ostojaatanasijevic/PSG10M/README.md

# PSG10M

PSG10M is a simple 10 MHz signal generator. 

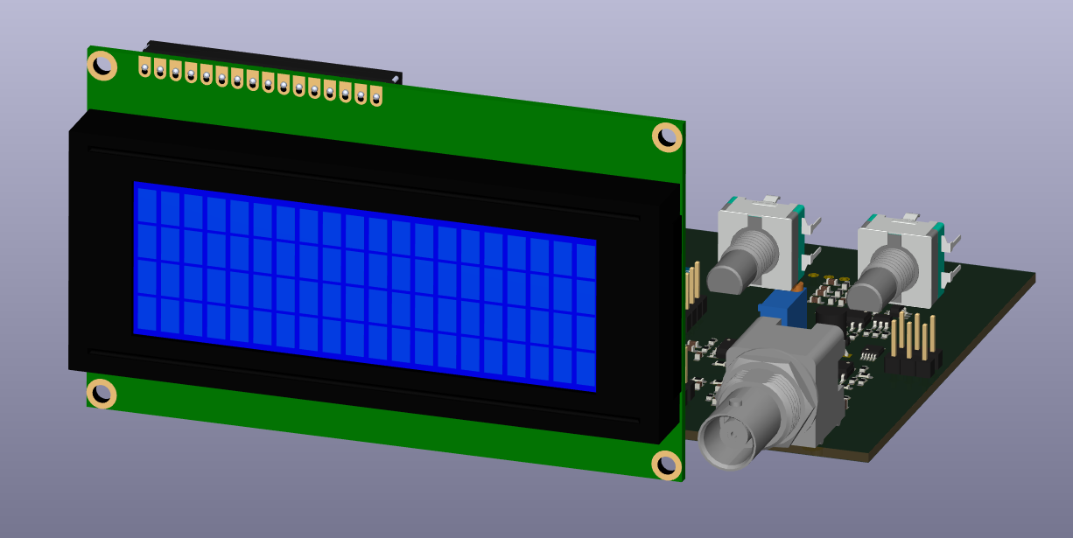
[picture p1: figs/PSG.png]
plot
