ostojaatanasijevic/PSG10M/LCD 16X2.STEP

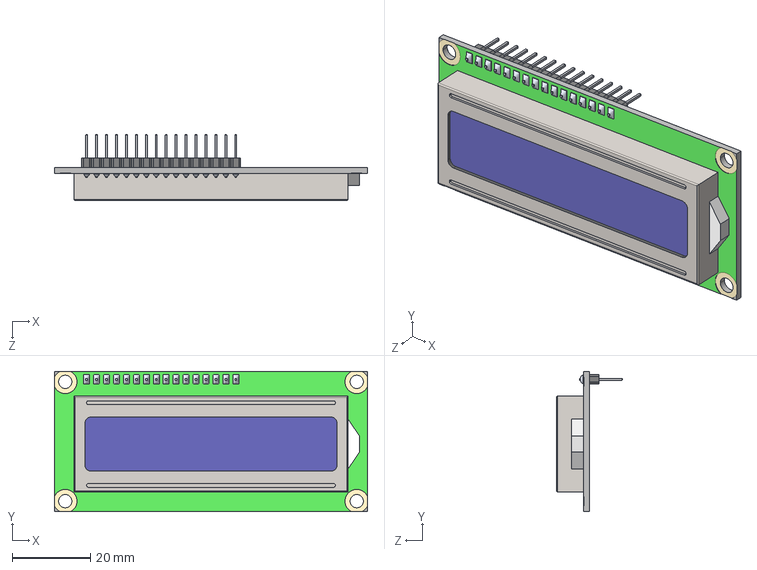
[picture p2: CAD file, 2024-11-09]
LCD 16X2.STEP
80.0 x 35.8 x 16.9 mm
