ostojaatanasijevic/PSG10M/1-5227161-6.stp

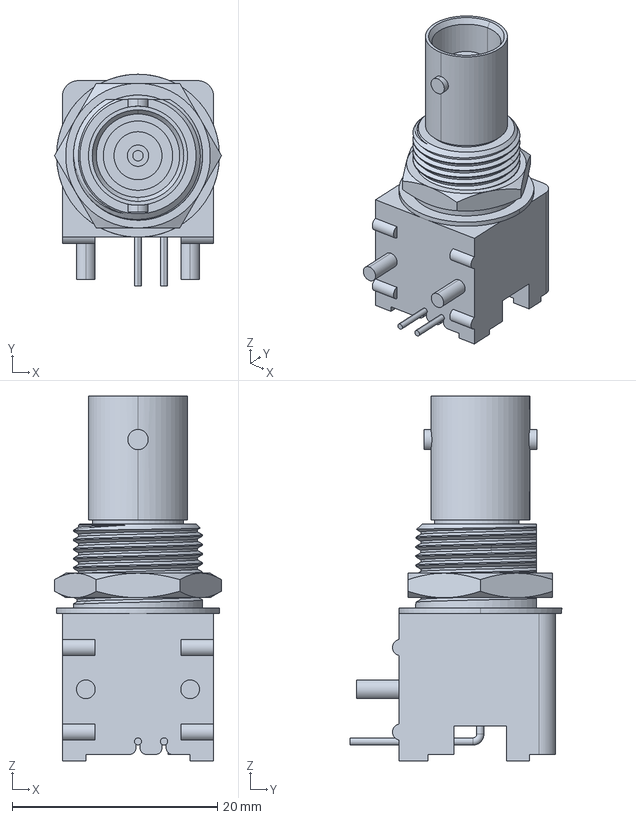
[picture p3: CAD file, 2024-11-02]
1-5227161-6.stp
16.3 x 20.6 x 35.6 mm
