ostojaatanasijevic/PSG10M/Ël__h.STEP

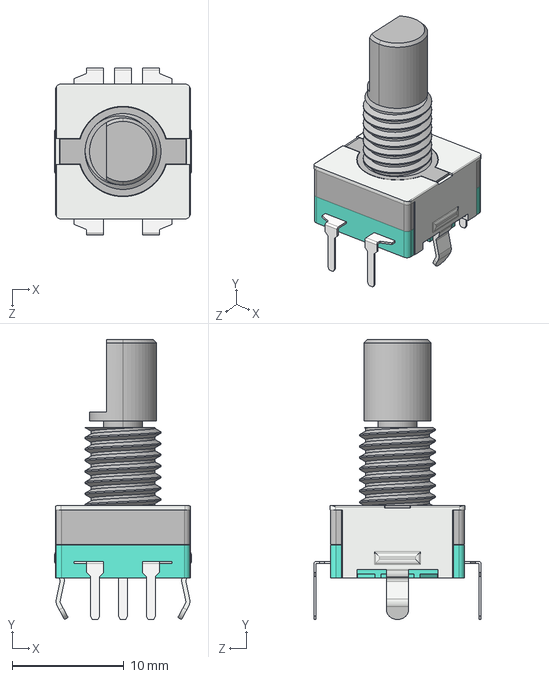
[picture p4: CAD file, 2024-11-02]
Ël__h.STEP
12.3 x 25.1 x 15.0 mm
