ostojaatanasijevic/PSG10M/LCD 20x4 Display.step

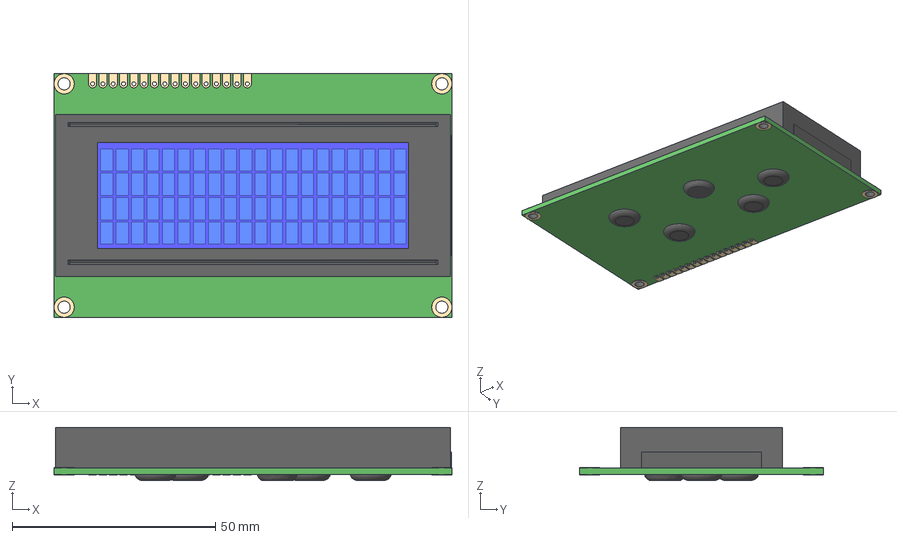
[picture p5: CAD file, 2024-11-02]
LCD 20x4 Display.step
98.0 x 60.0 x 13.1 mm
