ostojaatanasijevic/PSG10M/I2C LCD Adapter PCF8574.step

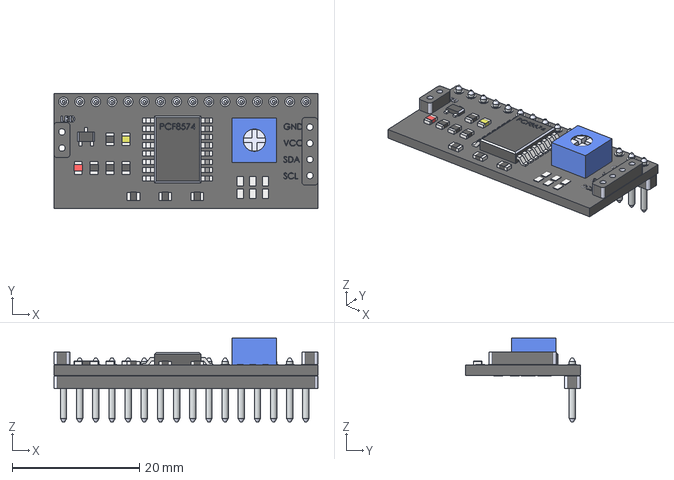
[picture p6: CAD file, 2024-11-02]
I2C LCD Adapter PCF8574.step
41.5 x 18.0 x 13.1 mm
