ostojaatanasijevic/PSG10M/simulacije/201_cd_offset.asc

C1: cap; 1µ
R1: res; 430
R2: res; 100
R3: res; 1k
R4: res; 430
R5: res; 430
R6: res; {(1 - x) * 1k}
R7: res; {(1 - x) * 1k}
R8: res; 100
R9: res; 200
R10: res; 200
R11: res; 100
R12: res; 200
R13: res; 100
R14: res; 100
R15: res; 1k
R16: res; 1k
R17: res; 100
U1: AD8009an
U2: LM339A_TI
U3: AD8009an
U4: AD8009an
U5: opamp2; LM7171
U6: AD8009an
U7: TL072
V1: voltage; PULSE(0 0.6 0 1n 1n 0.5u 1u)
V2: voltage; 5
V3: voltage; 5
V4: voltage; 15.3
V5: voltage; 15.3
V6: voltage; 0.1
Named nets: 5V, -5V, 0, -15V3, 15V3
.tran 1m
.param x = 0.5
.lib lm7171.lib
