ostojaatanasijevic/PSG10M/simulacije/101_amp.asc

R1: res; 430
R2: res; 100
R3: res; 1k
R4: res; 430
R5: res; 430
R6: res; {(1 - x) * 1k}
R7: res; {(1 - x) * 1k}
R8: res; 100
R9: res; 220
U1: AD8009an
U2: LM339A_TI
U3: AD8009an
U4: AD8009an
V1: voltage; SINE(0.325 0.3 1Meg)
V2: voltage; 5
V3: voltage; 5
Named nets: 5V, -5V, 0
.tran 1m
.param x = 0.5
