ostojaatanasijevic/PSG10M/simulacije/801_PWM_DAC.asc

C1: cap; 100n
C2: cap; 100n
R1: res; 100k
R2: res; 100k
V1: voltage; PULSE(0 1 0 10u 10u 1n 20u)
Named nets: 0
.tran 1000m
