ostojaatanasijevic/PSG10M/simulacije/901_output_filter.asc

C1: cap; 47p
C2: cap; 47p
C3: cap; 47p
C5: cap; 1p
C6: cap; 5.6p
C7: cap; 4.7p
L1: ind; 330n
L2: ind; 330n
L3: ind; 330n
R1: res; 200
V1: voltage; ""; AC 1
Named nets: 0
;tran 1000m
.ac dec 100 100k 100Meg
