ostojaatanasijevic/PSG10M/simulacije/701_capacitance_multiplier.asc

B1: bv; V=-V(vcc_in)
C1: cap; 47µ
I1: current; 30m
R1: res; 1k
R2: res; 10k
R3: res; 1k
R322: res; 3.3k
U2: bd679
V1: voltage; PULSE(-1 1 0 10u 10u 1n 20u)
V2: voltage; 20
V3: voltage; PULSE(-1 1 0 {t2} {t2} 1n {2*t2})
V4: voltage; 9
Named nets: 0, vee_in, vcc_in
.tran 1000m
.param t2 = 0.5u
.lib BD679.SP3
