ostojaatanasijevic/PSG10M/PSG10M.kicad_pcb

## KiCad design PSG10M.kicad_pcb (2025-01-06)

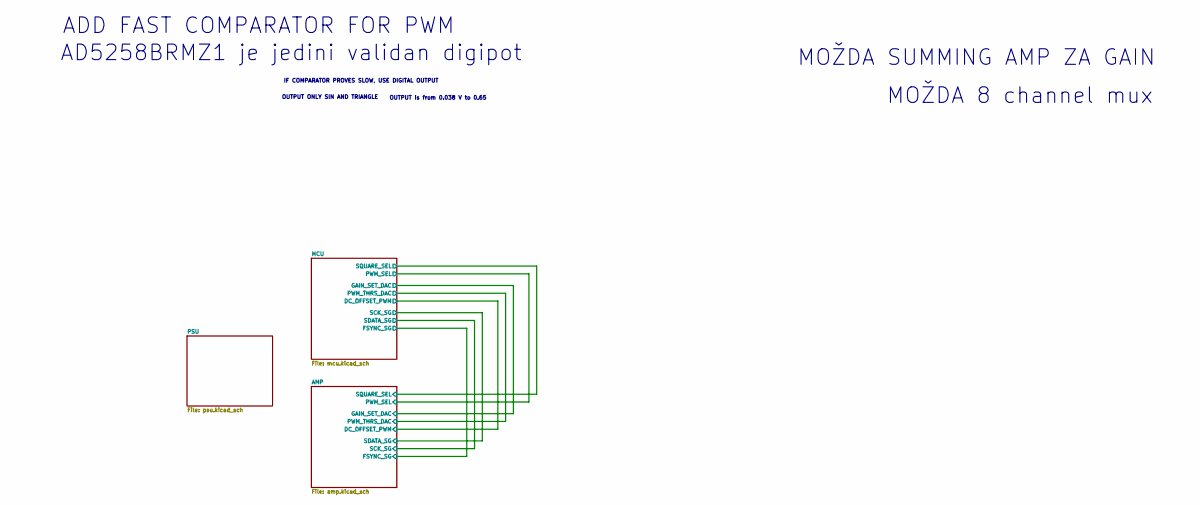
[picture p7: schematic PSG10M.kicad_sch]

Notes on the sheet:
OUTPUT is from 0.038 V to 0.65
IF COMPARATOR PROVES SLOW, USE DIGITAL OUTPUT
ADD FAST COMPARATOR FOR PWM
MOŽDA 8 channel mux
OUTPUT ONLY SIN AND TRIANGLE
AD5258BRMZ1 je jedini validan digipot
MOŽDA SUMMING AMP ZA GAIN

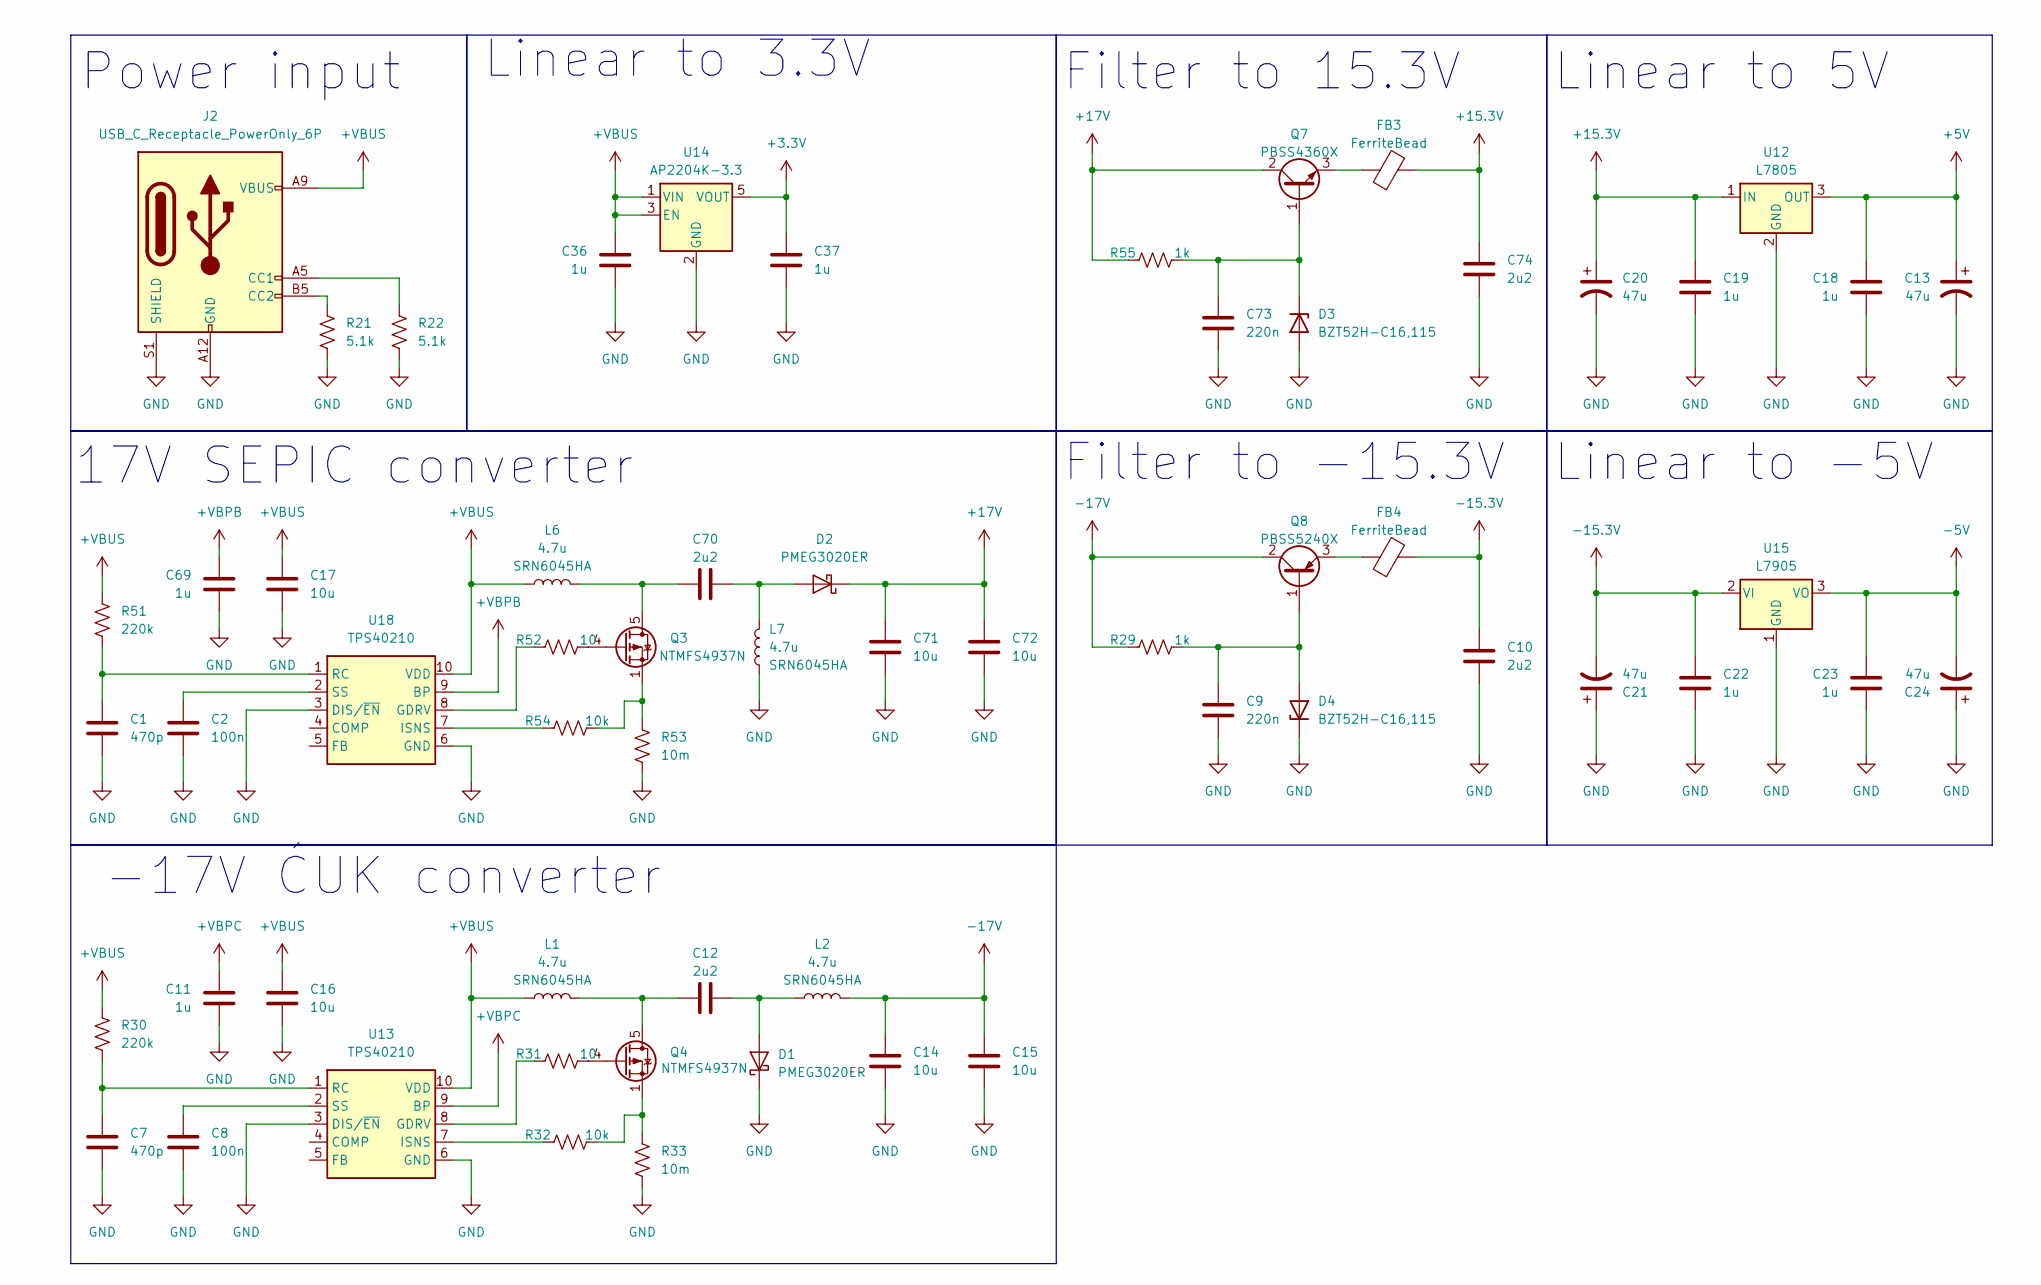
[picture p8: schematic psu.kicad_sch]

Parts:
C1, C7: 470p; R_0603_1608Metric_Pad0.98x0.95mm_HandSolder
C2, C8: 100n; R_0603_1608Metric_Pad0.98x0.95mm_HandSolder
C9, C73: 220n; R_0603_1608Metric_Pad0.98x0.95mm_HandSolder
C10, C12, C70, C74: 2u2; R_1206_3216Metric_Pad1.30x1.75mm_HandSolder
C11, C18, C19, C22, C23, C36, C37, C69: 1u; R_0603_1608Metric_Pad0.98x0.95mm_HandSolder
C13, C20, C21, C24: 47u; CP_Radial_D5.0mm_P2.00mm
C14, C15, C16, C17, C71, C72: 10u; R_1206_3216Metric
D1, D2: PMEG3020ER; D_SOD-128
D3, D4: BZT52H-C16,115; D_SOD-123F
FB3, FB4: FerriteBead
J2: USB_C_Receptacle_PowerOnly_6P; USB_C_Receptacle_GCT_USB4125-xx-x_6P_TopMnt_Horizontal
L1, L2, L6, L7: 4.7u; L_Bourns_SRN6045TA; Partname SRN6045HA
Q3, Q4: NTMFS4937N; PowerPAK_SO-8_Single
Q7: PBSS4360X; SOT-89-3
Q8: PBSS5240X; SOT-89-3
R21, R22: 5.1k; R_0603_1608Metric_Pad0.98x0.95mm_HandSolder
R29, R55: 1k; R_0603_1608Metric_Pad0.98x0.95mm_HandSolder
R30, R51: 220k; R_0603_1608Metric_Pad0.98x0.95mm_HandSolder
R31, R52: 10; R_0603_1608Metric_Pad0.98x0.95mm_HandSolder
R32, R54: 10k; R_0603_1608Metric_Pad0.98x0.95mm_HandSolder
R33, R53: 10m; R_2512_6332Metric_Pad1.40x3.35mm_HandSolder
U12: L7805; TO-220-3_Vertical
U13, U18: TPS40210; HVSSOP-10-1EP_3x3mm_P0.5mm_EP1.57x1.88mm
U14: AP2204K-3.3; SOT-23-5
U15: L7905; TO-220-3_Vertical

Connections:
+3.3V: C37.1, U14.5 (VOUT); also elsewhere on the board
+5V: C13.1, C18.1, U12.3 (OUT); also elsewhere on the board
+15.3V: C19.1, C20.1, C74.2, FB3.2, U12.1 (IN)
+17V: C71.1, C72.1, D2.1 (K), Q7.2 (C), R55.2
+VBPB: C69.1, U18.9 (BP)
+VBPC: C11.1, U13.9 (BP)
+VBUS: C16.1, C17.1, C36.1, J2.A9 (VBUS), J2.B9 (VBUS), L1.1, L6.1, R30.2, R51.2, U13.10 (VDD), U14.1 (VIN), U14.3 (EN), U18.10 (VDD); also elsewhere on the board
-5V: C23.1, C24.2, U15.3 (VO); also elsewhere on the board
-15.3V: C10.2, C21.2, C22.1, FB4.2, U15.2 (VI)
-17V: C14.1, C15.1, L2.2, Q8.2 (C), R29.2
GND: C1.2, C2.2, C7.2, C8.2, C9.2, C10.1, C11.2, C13.2, C14.2, C15.2, C16.2, C17.2, C18.2, C19.2, C20.2, C21.1, C22.2, C23.2, C24.1, C36.2, C37.2, C69.2, C71.2, C72.2, C73.2, C74.1, D1.1 (K), D3.2 (A), D4.1 (K), J2.A12 (GND), J2.B12 (GND), J2.S1 (SHIELD), L7.1, R21.1, R22.1, R33.2, R53.2, U12.2 (GND), U13.3 (DIS/~EN), U13.6 (GND), U14.2 (GND), U15.1 (GND), U18.3 (DIS/~EN), U18.6 (GND); also elsewhere on the board
unnamed: C12.2, D1.2 (A), L2.1
unnamed: C70.2, D2.2 (A), L7.2
unnamed: C73.1, D3.1 (K), Q7.1 (B), R55.1
unnamed: C9.1, D4.2 (A), Q8.1 (B), R29.1
unnamed: J2.A5 (CC1), R22.2
unnamed: J2.B5 (CC2), R21.2
unnamed: C70.1, L6.2, Q3.5 (D)
unnamed: Q3.4 (G), R52.1
unnamed: Q3.1 (S), Q3.2 (S), Q3.3 (S), R53.1, R54.1
unnamed: C12.1, L1.2, Q4.5 (D)
unnamed: Q4.4 (G), R31.1
unnamed: Q4.1 (S), Q4.2 (S), Q4.3 (S), R32.1, R33.1
unnamed: FB3.1, Q7.3 (E)
unnamed: FB4.1, Q8.3 (E)
unnamed: R31.2, U13.8 (GDRV)
unnamed: R32.2, U13.7 (ISNS)
unnamed: C7.1, R30.1, U13.1 (RC)
unnamed: C8.1, U13.2 (SS)
unnamed: R52.2, U18.8 (GDRV)
unnamed: R54.2, U18.7 (ISNS)
unnamed: C1.1, R51.1, U18.1 (RC)
unnamed: C2.1, U18.2 (SS)

Notes on the sheet:
Filter to 15.3V
Linear to 5V
Linear to -5V
-17V ĆUK converter
Filter to -15.3V
17V SEPIC converter
Power input
Linear to 3.3V

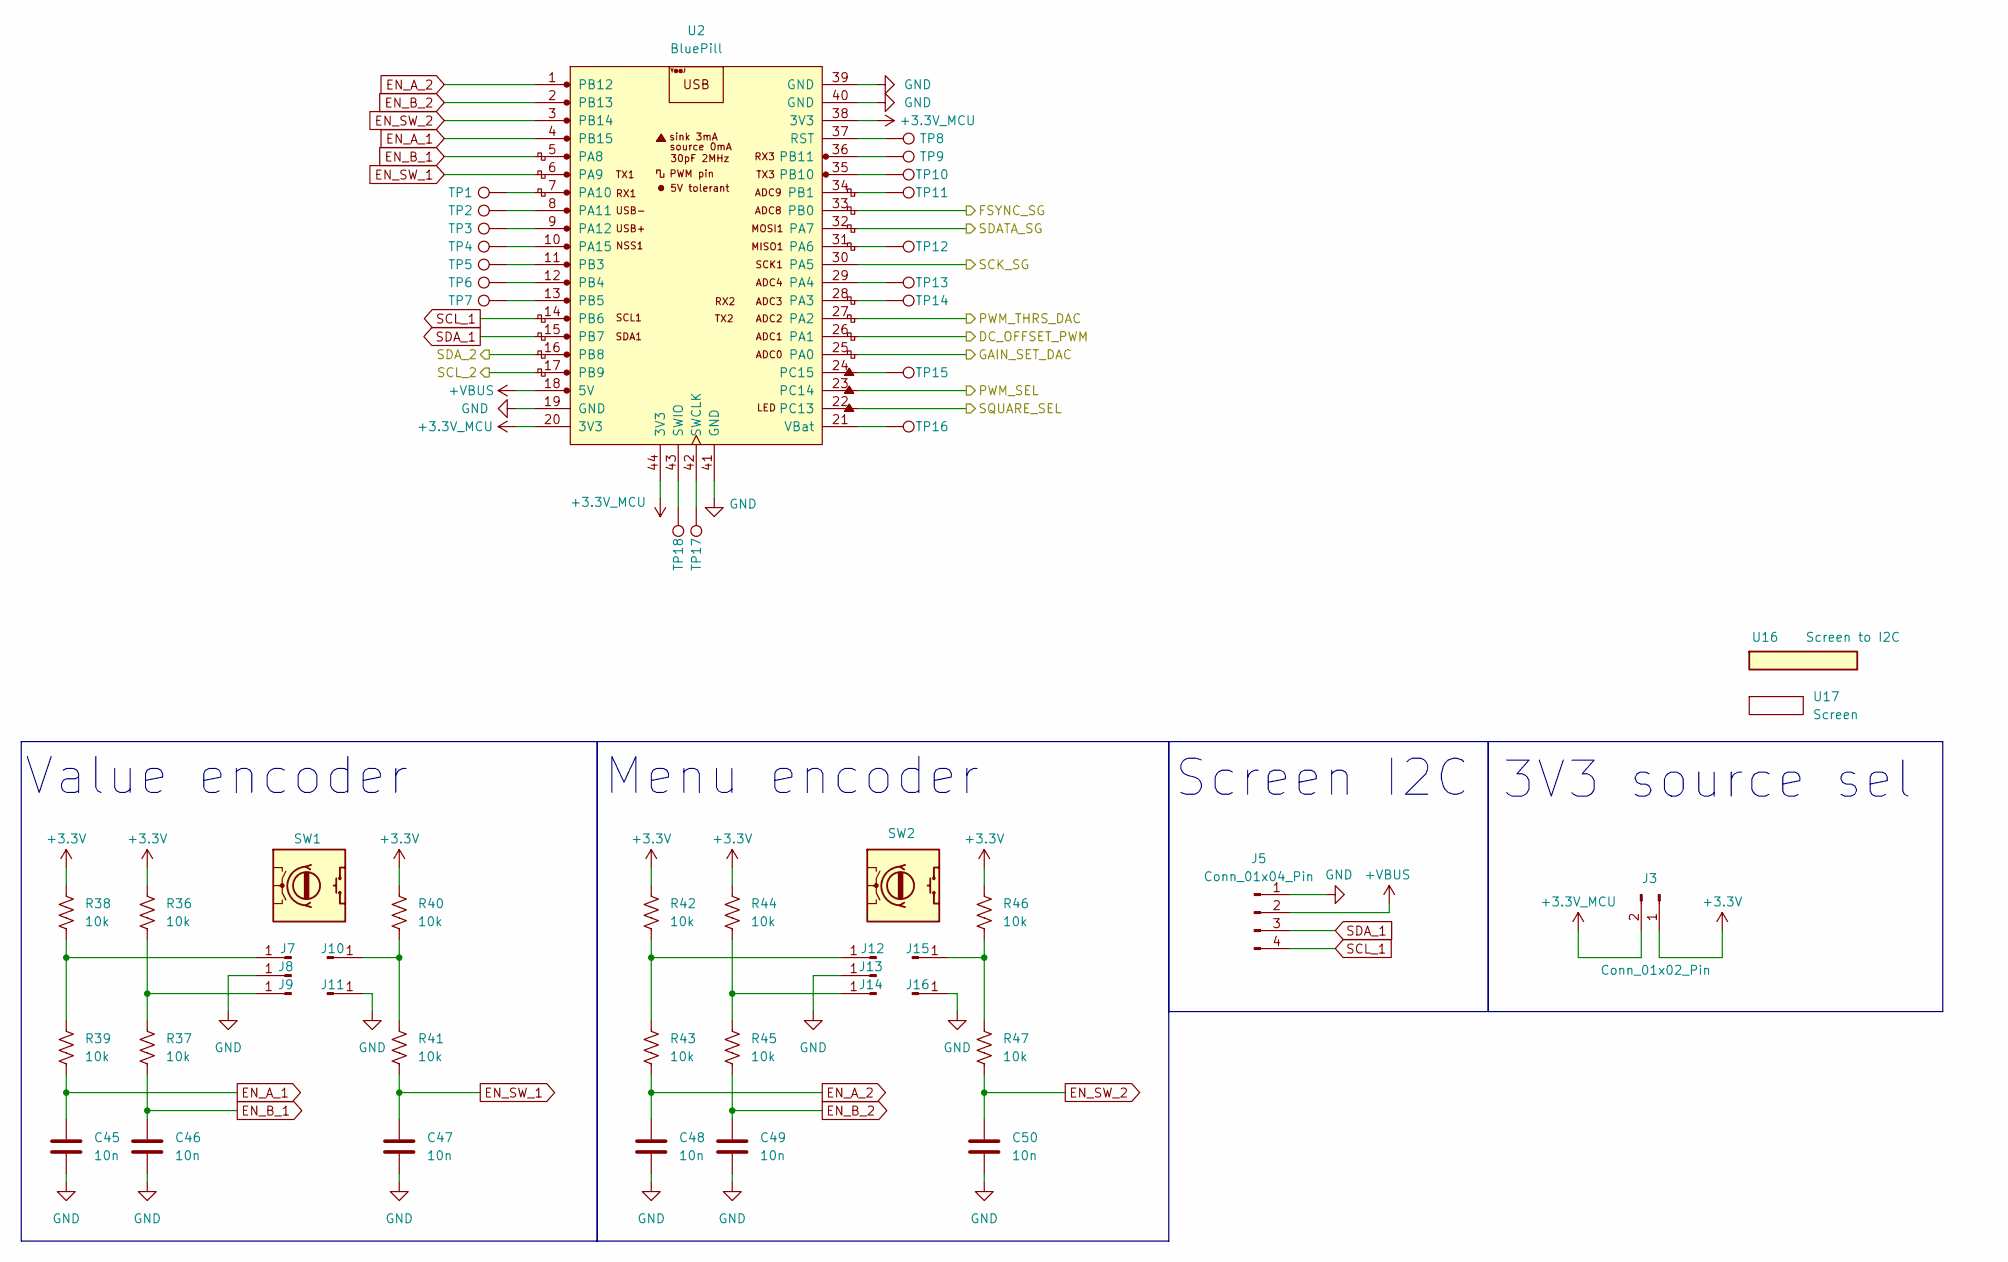
[picture p9: schematic mcu.kicad_sch]

Parts:
C45, C46, C47, C48, C49, C50: 10n; R_0603_1608Metric_Pad0.98x0.95mm_HandSolder
J3: Conn_01x02_Pin; PinHeader_1x02_P2.54mm_Vertical
J5: Conn_01x04_Pin; PinHeader_1x04_P2.54mm_Vertical
J7, J8, J9, J10, J11, J12, J13, J14, J15, J16: Conn_01x01_Pin; PinHeader_1x01_P2.54mm_Vertical
R36, R37, R38, R39, R40, R41, R42, R43, R44, R45, R46, R47: 10k; R_0603_1608Metric_Pad0.98x0.95mm_HandSolder
SW1, SW2: RotaryEncoder_Switch; RotaryEncoder_Bourns_Vertical_PEC12R-3x17F-Sxxxx
TP1, TP2, TP3, TP4, TP5, TP6, TP7, TP8, TP9, TP10, TP11, TP12, TP13, TP14, TP15, TP16, TP17, TP18: TestPoint; TestPoint_Pad_D3.0mm
U2: BluePill
U16: Screen to I2C; screen_to_i2c
U17: Screen; 2x16_vertical

Connections:
+3.3V: J3.1, R36.2, R38.2, R40.2, R42.2, R44.2, R46.2; also elsewhere on the board
+3.3V_MCU: J3.2, U2.20 (3V3), U2.38 (3V3), U2.44 (3V3)
+VBUS: J5.2, U2.18 (5V); also elsewhere on the board
/AMP/DC_OFFSET_PWM: U2.26 (PA1); also elsewhere on the board
/AMP/FSYNC_SG: U2.33 (PB0); also elsewhere on the board
/AMP/GAIN_SET_DAC: U2.25 (PA0); also elsewhere on the board
/AMP/PWM_SEL: U2.23 (PC14); also elsewhere on the board
/AMP/PWM_THRS_DAC: U2.27 (PA2); also elsewhere on the board
/AMP/SCK_SG: U2.32 (PA7); also elsewhere on the board
/AMP/SDATA_SG: U2.30 (PA5); also elsewhere on the board
/AMP/SQUARE_SEL: U2.22 (PC13); also elsewhere on the board
/MCU/SCL_2: U2.17 (PB9)
/MCU/SDA_2: U2.16 (PB8)
EN_A_1: C45.2, R39.1, U2.4 (PB15)
EN_A_2: C48.2, R43.1, U2.1 (PB12)
EN_B_1: C46.2, R37.1, U2.5 (PA8)
EN_B_2: C49.2, R45.1, U2.2 (PB13)
EN_SW_1: C47.2, R41.1, U2.6 (PA9)
EN_SW_2: C50.2, R47.1, U2.3 (PB14)
GND: C45.1, C46.1, C47.1, C48.1, C49.1, C50.1, J5.1, J8.1, J11.1, J13.1, J16.1, U2.19 (GND), U2.39 (GND), U2.40 (GND), U2.41 (GND); also elsewhere on the board
unnamed: J7.1, R38.1, R39.2
unnamed: J9.1, R36.1, R37.2
unnamed: J10.1, R40.1, R41.2
unnamed: J12.1, R42.1, R43.2
unnamed: J14.1, R44.1, R45.2
unnamed: J15.1, R46.1, R47.2
unnamed: TP14.1, U2.28 (PA3)
unnamed: TP13.1, U2.29 (PA4)
unnamed: TP12.1, U2.31 (PA6)
unnamed: TP1.1, U2.7 (PA10)
unnamed: TP2.1, U2.8 (PA11)
unnamed: TP3.1, U2.9 (PA12)
unnamed: TP4.1, U2.10 (PA15)
unnamed: TP11.1, U2.34 (PB1)
unnamed: TP5.1, U2.11 (PB3)
unnamed: TP6.1, U2.12 (PB4)
unnamed: TP7.1, U2.13 (PB5)
unnamed: TP10.1, U2.35 (PB10)
unnamed: TP9.1, U2.36 (PB11)
unnamed: TP15.1, U2.24 (PC15)
unnamed: TP8.1, U2.37 (RST)
unnamed: TP17.1, U2.42 (SWCLK)
unnamed: TP18.1, U2.43 (SWIO)
unnamed: TP16.1, U2.21 (VBat)
SCL_1: J5.4, U2.14 (PB6)
SDA_1: J5.3, U2.15 (PB7)

Notes on the sheet:
Screen I2C
Menu encoder
3V3 source sel
Value encoder

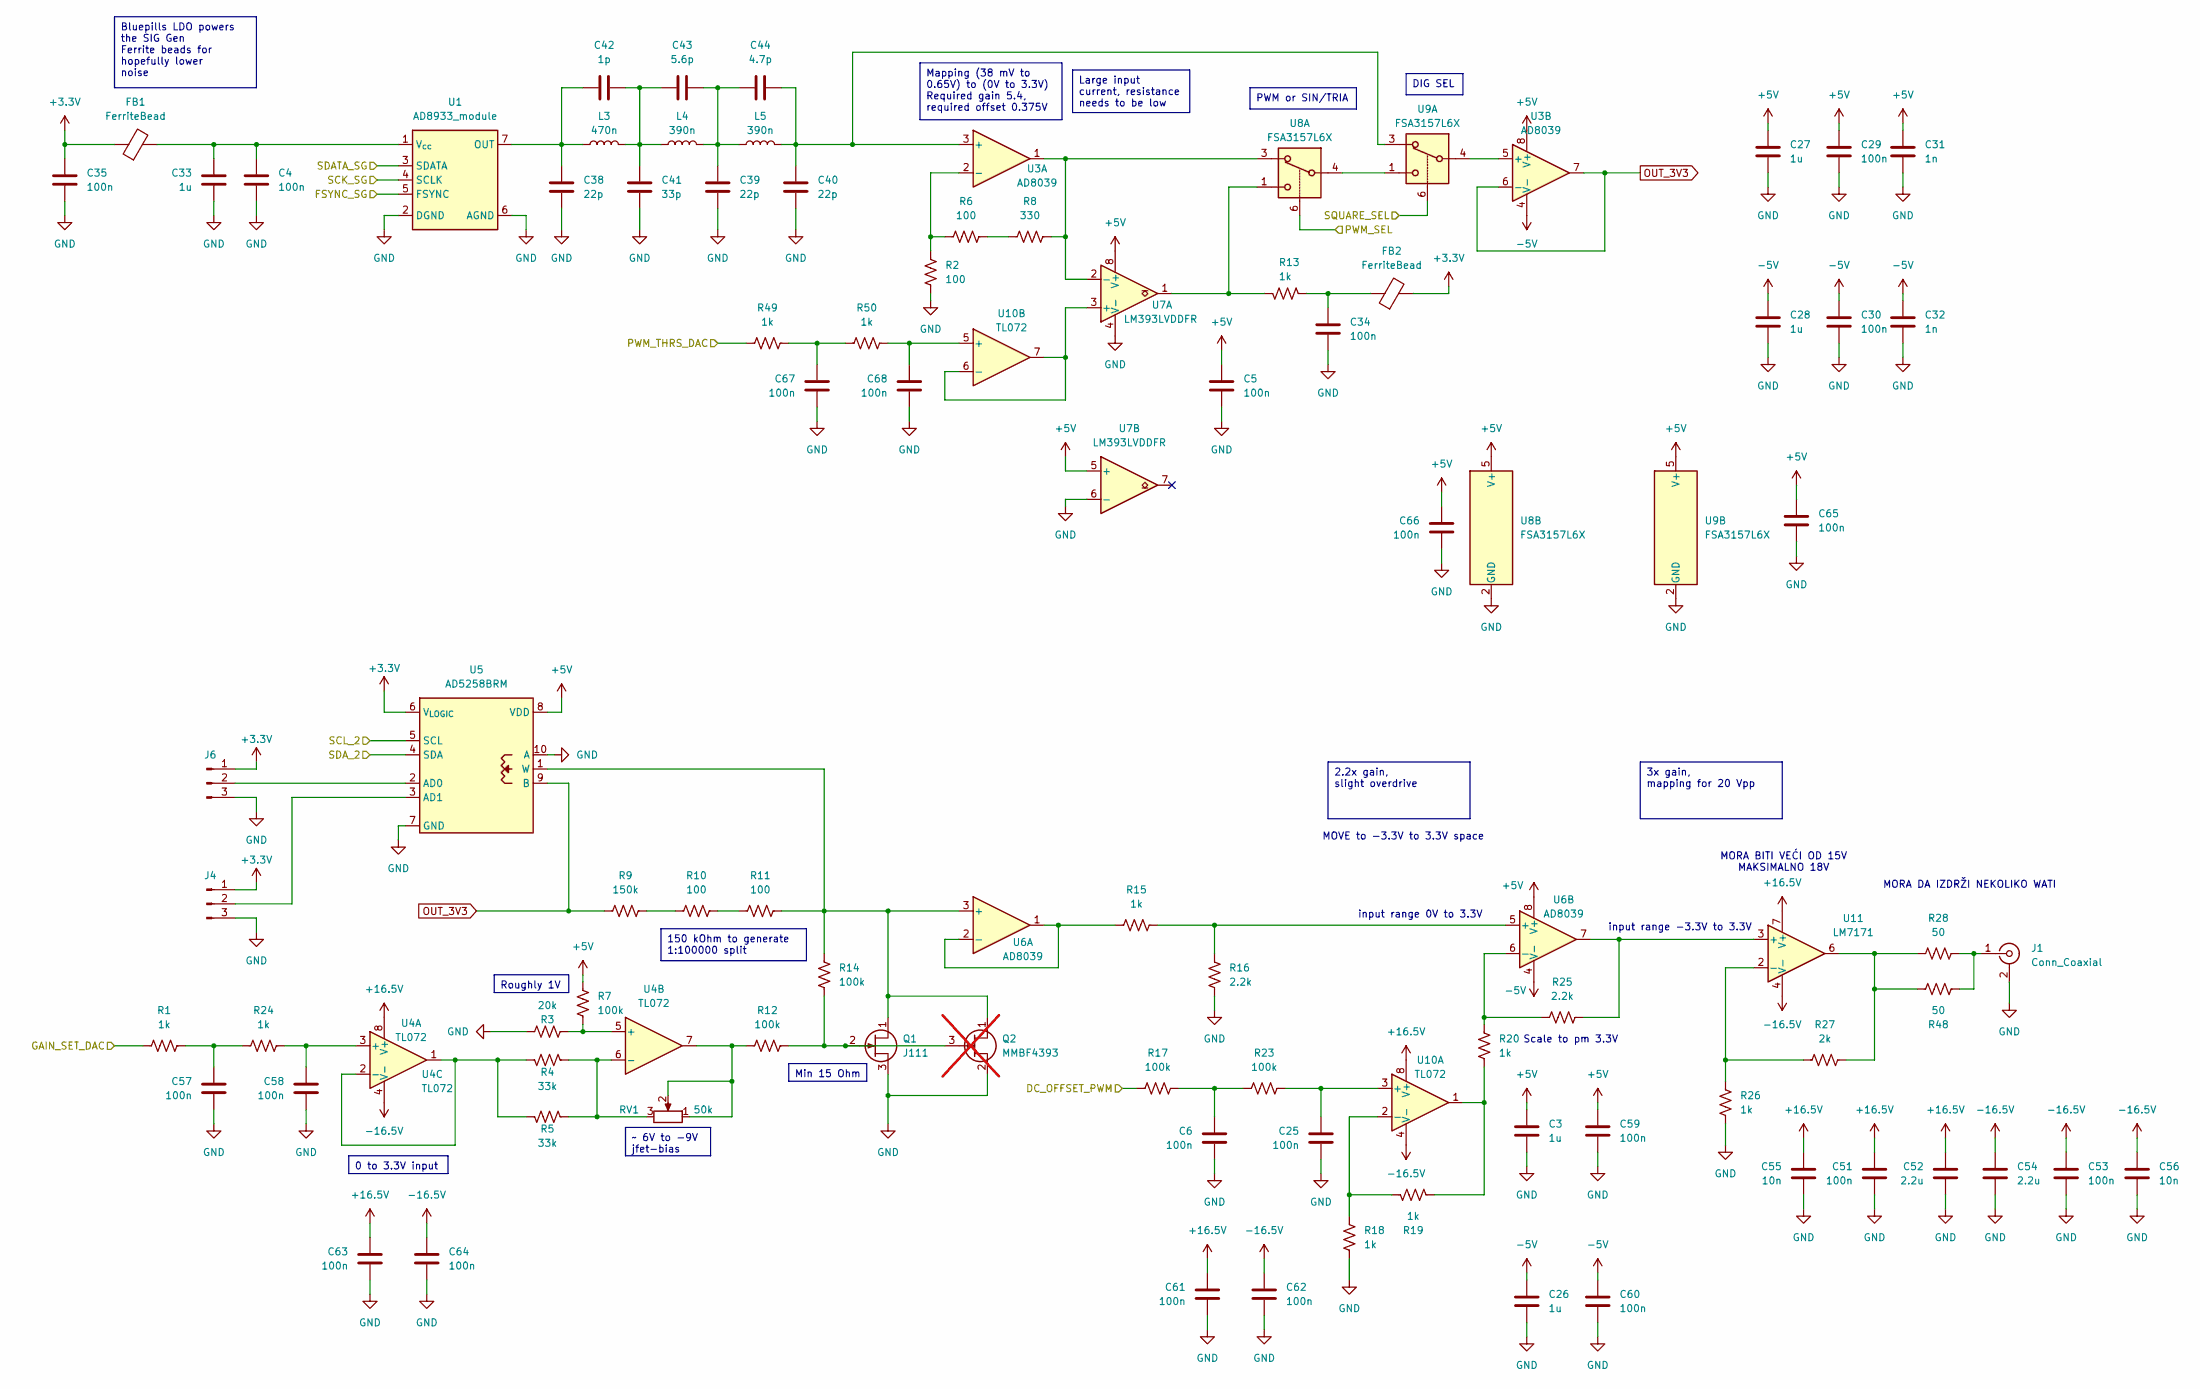
[picture p10: schematic amp.kicad_sch]

Parts:
C3, C26, C27, C28, C33: 1u; R_0603_1608Metric_Pad0.98x0.95mm_HandSolder
C4, C5, C6, C25, C34, C35, C51, C53, C57, C58, C61, C62, C63, C64, C65, C66, C67, C68: 100n; C_0603_1608Metric_Pad1.08x0.95mm_HandSolder
C29, C30, C59, C60: 100n; R_0603_1608Metric_Pad0.98x0.95mm_HandSolder
C31, C32: 1n; R_0603_1608Metric_Pad0.98x0.95mm_HandSolder
C38, C39, C40: 22p; C_0603_1608Metric_Pad1.08x0.95mm_HandSolder
C41: 33p; C_0603_1608Metric_Pad1.08x0.95mm_HandSolder
C42: 1p; C_0603_1608Metric_Pad1.08x0.95mm_HandSolder
C43: 5.6p; C_0603_1608Metric_Pad1.08x0.95mm_HandSolder
C44: 4.7p; C_0603_1608Metric_Pad1.08x0.95mm_HandSolder
C52, C54: 2.2u; C_1206_3216Metric_Pad1.33x1.80mm_HandSolder
C55, C56: 10n; C_0603_1608Metric_Pad1.08x0.95mm_HandSolder
FB1, FB2: FerriteBead; L_0603_1608Metric_Pad1.05x0.95mm_HandSolder
J1: Conn_Coaxial; BNC_Amphenol_B6252HB-NPP3G-50_Horizontal
J4, J6: Conn_01x03_Pin; PinHeader_1x03_P2.54mm_Vertical
L3: 470n; L_0603_1608Metric
L4, L5: 390n; L_0603_1608Metric
Q1: J111; TO-92_Inline_Wide
Q2: MMBF4393; SOT-23; not fitted
R1, R13, R15, R18, R19, R20, R24, R26, R49, R50: 1k; R_0603_1608Metric_Pad0.98x0.95mm_HandSolder
R2, R6, R10, R11: 100; R_0603_1608Metric_Pad0.98x0.95mm_HandSolder
R3: 20k; R_0603_1608Metric_Pad0.98x0.95mm_HandSolder
R4, R5: 33k; R_0603_1608Metric_Pad0.98x0.95mm_HandSolder
R7, R12, R14, R17, R23: 100k; R_0603_1608Metric_Pad0.98x0.95mm_HandSolder
R8: 330; R_0603_1608Metric_Pad0.98x0.95mm_HandSolder
R9: 150k; R_0603_1608Metric_Pad0.98x0.95mm_HandSolder
R16, R25: 2.2k; R_0603_1608Metric_Pad0.98x0.95mm_HandSolder
R27: 2k; R_0603_1608Metric_Pad0.98x0.95mm_HandSolder
R28, R48: 50; R_0603_1608Metric_Pad0.98x0.95mm_HandSolder
RV1: 50k; Potentiometer_Bourns_3296W_Vertical
U1: AD8933_module; AD9833_module
U3, U6: AD8039; SOIC-8_3.9x4.9mm_P1.27mm
U4, U10: TL072; SOIC-8_3.9x4.9mm_P1.27mm
U5: AD5258BRM; MSOP-10_3x3mm_P0.5mm
U7: LM393LVDDFR; SOT-223-8
U8, U9: FSA3157L6X; SOT-23-6_Handsoldering
U11: LM7171; SOIC-8_3.9x4.9mm_P1.27mm

Connections:
+3.3V: C35.1, FB1.1, FB2.2, J4.1, J6.1, U5.6 (V_{LOGIC}); also elsewhere on the board
+5V: C3.2, C5.1, C27.2, C29.2, C31.2, C59.2, C65.1, C66.1, R7.2, U3.8 (V+), U5.8 (VDD), U6.8 (V+), U7.5 (+), U7.8 (V+), U8.5 (V+), U9.5 (V+); also elsewhere on the board
+16.5V: C51.1, C52.1, C55.1, C61.1, C63.1, U4.8 (V+), U10.8 (V+), U11.7 (V+)
-5V: C26.2, C28.2, C30.2, C32.2, C60.2, U3.4 (V-), U6.4 (V-); also elsewhere on the board
-16.5V: C53.1, C54.1, C56.1, C62.1, C64.1, U4.4 (V-), U10.4 (V-), U11.4 (V-)
/AMP/DC_OFFSET_PWM: R17.1; also elsewhere on the board
/AMP/FSYNC_SG: U1.5 (FSYNC); also elsewhere on the board
/AMP/GAIN_SET_DAC: R1.1; also elsewhere on the board
/AMP/PWM_SEL: U8.6; also elsewhere on the board
/AMP/PWM_THRS_DAC: R49.1; also elsewhere on the board
/AMP/SCK_SG: U1.4 (SCLK); also elsewhere on the board
/AMP/SCL_2: U5.5 (SCL)
/AMP/SDATA_SG: U1.3 (SDATA); also elsewhere on the board
/AMP/SDA_2: U5.4 (SDA)
/AMP/SQUARE_SEL: U9.6; also elsewhere on the board
GND: C3.1, C4.2, C5.2, C6.2, C25.2, C26.1, C27.1, C28.1, C29.1, C30.1, C31.1, C32.1, C33.1, C34.2, C35.2, C38.2, C39.2, C40.2, C41.2, C51.2, C52.2, C53.2, C54.2, C55.2, C56.2, C57.2, C58.2, C59.1, C60.1, C61.2, C62.2, C63.2, C64.2, C65.2, C66.2, C67.2, C68.2, J1.2 (Ext), J4.3, J6.3, Q1.3 (S), Q2.2 (S), R2.1, R3.1, R16.1, R18.1, R26.1, U1.2 (DGND), U1.6 (AGND), U5.7 (GND), U5.10 (A), U7.4 (V-), U7.6 (-), U8.2 (GND), U9.2 (GND); also elsewhere on the board
unnamed: C6.1, R17.2, R23.1
unnamed: C34.1, FB2.1, R13.2
unnamed: C39.1, C43.2, C44.1, L4.2, L5.1
unnamed: C41.1, C42.2, C43.1, L3.2, L4.1
unnamed: C57.1, R1.2, R24.1
unnamed: C67.1, R49.2, R50.1
unnamed: J1.1 (In), R28.2, R48.1
unnamed: J4.2, U5.3 (AD1)
unnamed: J6.2, U5.2 (AD0)
unnamed: Q1.1 (D), Q2.1 (D), R11.2, R14.2, U5.1 (W), U6.3 (+)
unnamed: Q1.2 (G), Q2.3 (G), R12.1, R14.1
unnamed: R6.2, R8.1
unnamed: R9.2, R10.1
unnamed: R10.2, R11.1
unnamed: R12.2, RV1.1, RV1.2, U4.7
unnamed: R13.1, U7.1, U8.1
unnamed: R19.2, R20.1, U10.1
unnamed: R27.2, R28.1, R48.2, U11.6
unnamed: C38.1, C42.1, L3.1, U1.7 (OUT)
unnamed: C4.1, C33.2, FB1.2, U1.1 (V_{cc})
unnamed: C40.1, C44.2, L5.2, U3.3 (+), U9.3
unnamed: R2.2, R6.1, U3.2 (-)
unnamed: U3.5 (+), U9.4
unnamed: C58.1, R24.2, U4.3 (+)
unnamed: R4.1, R5.1, U4.1, U4.2 (-)
unnamed: R3.2, R7.1, U4.5 (+)
unnamed: R4.2, R5.2, RV1.3, U4.6 (-)
unnamed: R15.1, U6.1, U6.2 (-)
unnamed: R15.2, R16.2, U6.5 (+)
unnamed: R20.2, R25.1, U6.6 (-)
unnamed: R8.2, U3.1, U7.2 (-), U8.3
unnamed: U8.4, U9.1
unnamed: C25.1, R23.2, U10.3 (+)
unnamed: R18.2, R19.1, U10.2 (-)
unnamed: C68.1, R50.2, U10.5 (+)
unnamed: U7.3 (+), U10.6 (-), U10.7
unnamed: R25.2, U6.7, U11.3 (+)
unnamed: R26.2, R27.1, U11.2 (-)
OUT_3V3: R9.1, U3.6 (-), U3.7, U5.9 (B)

Notes on the sheet:
~ 6V to -9V jfet-bias
150 kOhm to generate 1:100000 split
Roughly 1V
0 to 3.3V input
DIG SEL
Mapping (38 mV to 0.65V) to (0V to 3.3V) Required gain 5.4, required offset 0.375V
PWM or SIN/TRIA
2.2x gain, slight overdrive
Large input current, resistance needs to be low
3x gain, mapping for 20 Vpp
Min 15 Ohm
Bluepills LDO powers the SIG Gen Ferrite beads for hopefully lower noise
MORA BITI VEĆI OD 15V MAKSIMALNO 18V
Scale to pm 3.3V
MORA DA IZDRŽI NEKOLIKO WATI
MOVE to -3.3V to 3.3V space
input range -3.3V to 3.3V
input range 0V to 3.3V

Board: 2 copper layers, 201 parts (2 on the bottom side), 113 nets, no tracks yet.
