ostojaatanasijevic/PSG10M/(commit log)

2024-10-16 Ide nekako idk.
    [PSG10M.kicad_pcb, PSG10M.kicad_sch]
2024-10-27 Added DC offset, specifics TBD
    [PSG10M.kicad_sch]
2024-10-27 Save game. Power supply next.
    [PSG10M.kicad_sch]
2024-10-27 Working on PSY. Oddball values are fun.
    [PSG10M.kicad_sch, mcu.kicad_sch, psu.kicad_sch]
2024-11-02 Added readme.
    [1-5227161-6.stp, PSG10M.kicad_pcb]
2024-11-03 Updated spec.
    [PSG10M.kicad_pcb]
2024-12-12 Add the tested push-pull rail generator.
    [amp.kicad_sch, mcu.kicad_sch]
2025-01-06 SEPIC and CUK
    [PSG10M.kicad_pcb, amp.kicad_sch, psu.kicad_sch]
